Stew-000-1-0-011/mini-shirasu2/minishirasu-firm/spec.md

# minishirasu-firm
モタドラmini-shirasuのファームウェア。

board/下に基板の回路図等(sch, brd)がある。マイコンはSTM32F103C8T6。

設計の詳細は `docs/superpowers/specs/2026-10-03-minishirasu-firm-design.md` にある。

## 制御

CANで目標値を読み、モーターを動かす。

制御モードは電流、速度、位置の3つ。
カスケードしており、速度制御モードでは加速度FFを、位置制御モードでは速度FFと加速度FFを一緒に渡す。
加速度FFは外乱を含まない慣性分で、`accel_to_current`(= J/Kt)を掛けて電流に直し、速度PIの出力に足す。

電流制御は20kHz(PWMの毎周期)、速度・位置制御は1kHz。

## PWMとADC

TIM1のセンターアラインPWM。片側だけをPWMし、反対側はLow固定にする。

シャントはローサイド共通の1本なので、電流を測れるのは片側のハイサイドがONの間だけ。
ADCはONパルスの中央(カウンタの谷)で発火するようにする。
これはstm32f1xx-halのADCではできないので、レジスタ直打ちする。

- コンペア値の反映(更新イベント)はカウンタの山。`RCR = 1`をカウンタの起動前に書く。
- ADCのトリガはTIM1のチャネル4。`OC4REF`をTRGOに出し、谷の直前で立ち上げる。
- モーター電流の符号は、その周期に出していたデューティの向きから復元する。
- デューティが小さいとONパルスがサンプル時間より短くなり、電流を実際より小さく読む。

## 向き

正方向は、正のデューティ(PWMA側を駆動)で回る向き。逆回りを正にしたい場合は上位側で符号を反転する。

モーターとエンコーダの向きが食い違っていると、速度・位置ループが正帰還になって暴走する。
食い違いは設定`encoder_reversed`で吸収する。

## 通信

区切りのないバイトストリームを4本使う。CANではストリームごとにIDを1つ割り当て、
フレームのデータをストリームのバイト列としてそのまま連結する。IDは`src/config.rs`の定数。

| ストリーム | 向き | 既定のID | メッセージ |
|---|---|---|---|
| 目標値 | 受信 | 0x100 | TargetCurrent, TargetVelocity, TargetPosition |
| 状態 | 送信 | 0x101 | Status |
| コマンド | 受信 | 0x200 | SetMode, SetParam, ResetFault, SetOrigin |
| 応答 | 送信 | 0x201 | Ack, Nack, FaultNotice |

メッセージは `COBS( 種別 | ペイロード | CRC-8/SMBUS )` のあとに区切りの0x00。数値はリトルエンディアン。
種別、ペイロード、設定ID、Nackの理由は設計文書の「プロトコル」を見ること。

## 使い方

設定値に既定値はない。起動したら、まず`SetParam`で全項目(0x00〜0x23)を設定する。
全項目が揃って検証に通るまで、有効化(`SetMode`)は受け付けず、`Status`も送られない。
`Status`を受け取るには`status_period_ms`(0x24)も設定する。

1. `SetParam`で全項目を設定する。
2. `SetMode`で制御モードに入る。入った直後の目標値は、電流0 / 速度0 / 現在位置。
3. 目標値を送る。現在のモードと合わない目標値は捨てられる。
4. `SetMode`(0)で出力を止める。出力を止めるとモーターはフリーになる(ブレーキは掛からない)。

ドライバIC(MPQ6528)が異常を検出すると、出力を止めて`FaultNotice`を送り、`ResetFault`が来るまで復帰しない。
通信が途絶えても出力は止めない。ソフト側の過電流・電圧・温度の保護もない。

## 実機での確認手順

モーターを回す前に、上から順に確かめる。

1. 書き込んで起動ログを見る。`isense offset=...`が出て、エラーが出ないこと。
   - `update event is not at the peak`が出たら、`src/board.rs`の`RCR_BEFORE_START`を反対にして書き込み直す。
   - `ADC trigger or update event timing is wrong`が出たら、ADCが谷でトリガされていない。
2. オシロでISENSEのテストパッドとPWMAを見て、ADCのサンプル時刻が電流波形の平らな部分に入っていることを確かめる。
3. `SetParam`で全項目を設定する。電流上限`imax`とゲインは小さい値から始める。
4. `Status`が届くこと。母線電圧が実測と合うこと。
5. 手でモーターを回し、位置と速度の大きさが合うことを見る(`encoder_cpr`の確認)。
6. 電流モードで小さい正の電流を流し、`Status`の速度が正になることを見る。負なら`encoder_reversed`を切り替える。
7. 速度モード、位置モードを順に試す。
8. ログに`current loop missed the peak`が出ないことを見る。出る場合は電流ループの計算が25µsの半周期に間に合っていない。

### CANなしで試す

`cargo run --release --features bench`で書き込むと、CANからの指示なしで動く。
試験の内容は`src/bench.rs`の`PLAN`を書き換えて決める。

- `settings`を`SetParam`として順に設定し、`mode`に入り、`target`を与え、`run_ms`後に出力を止める。
  CANで受けたときと同じ入口に流し込むので、設定の検証と状態機械は同じコードを通る。
- `mode`が0なら設定だけして、出力は無効のままにする。
- 100msごとに`bench: mode=... i=... w=... th=... vdc=... temp=... flags=... late=...`をログに出す。
- コマンドが拒否されると`nack: command=... reason=... param=...`がログに出る。
- 目標値を与えた直後の400周期(20ms)ぶん、電流と出力を毎周期記録し、出力を止めたあとで
  `cap <位置>: i=[...] c=[...]`として書き出す。`i`は電流のADC値(1あたり約0.0201A)、
  `c`はコンペア値(1800でデューティ100%、PWMA側が正)。

CANの初期化は走るので、トランシーバがつながっていない基板では起動時に止まる。
