Stew-000-1-0-011/mini-shirasu2/docs/数値表現.md

# 数値表現

md-core の制御計算は、既定では固定小数点で行う。対象の STM32F103（Cortex-M3）には FPU がなく、f32 がソフトウェア演算になるため。
feature `f32` を有効にすると、同じ API のまま中身が浮動小数点になる（PC でのシミュレーションや FPU 付きマイコン用）。

## per-unit

信号とゲインは基準値で割って無次元化（per-unit 化）してから計算する。

| 量 | 基準値 | Config のフィールド |
|---|---|---|
| 電圧 | V_b | `vdcmax` |
| 電流 | I_b | `ibase` |
| 速度 | ω_b | `wbase` |
| トルク | Kt·I_b | （電流の per-unit 値と同じになるので持たない） |
| 位置 | 1 回転 = 1.0 | （基準値なし） |

`Config` は物理単位（V、A、rad/s、秒、回転）の f32 で持つ。per-unit への変換、周期 T の掛け込みは各 `Param::new` が行い、値が型に収まらなければ `ConfigError` を返す。
上限値（`imax`、`vmax`、`wmax`、`pmax`、`duty_max`、`dead_duty`）とゲイン（`cki`、`wkp`、`wki`、`pkp`）が負の場合や、`duty_max` が 1 を超える場合もエラーにする。`ke` と `wb` の符号は制限しない。

`NotPositive` になるのは次の場合。
- 基準値（`vdcmax`、`ibase`、`wbase`）、周期（`cperiod`、`wperiod`）、`ckp`、`i_threshold` が、正の有限値でない。
- `i_threshold` を `ibase` で割った値が Q3.28 の分解能より小さく、0 になる。0 だと電流 0 でもデッドタイム補償が掛かってしまうため。

変換後のゲインが 8 以上になる場合は `OutOfRange` になる（例: `ckp·ibase/vdcmax`、`wkp·wbase/ibase`）。基準値を選び直してゲインを収める。
- 電流の `ckp` は、`ibase` を小さくするか `vdcmax` を大きくすると per-unit 値が下がる。
- 速度の `wkp` は、`wbase` を小さくするか `ibase` を大きくすると per-unit 値が下がる。
- `ibase` と `wbase` は他の値の変換にも使われるので、変えたら他の値も範囲に収まるか確認する。

アンチワインドアップのゲイン `kb`（`cki·cperiod/ckp`）は 1 で頭打ちにする。飽和中の積分は kb が 2 を超えると発散するため。kb = 1 なら、飽和した周期のうちに積分値を戻せる。

`Measurement` と各制御器の目標値は per-unit で渡す。ADC の生値や CAN の物理値からの変換はファーム側の仕事。

## 型の使い分け

| 型 | 中身（既定 / feature `f32`） | 範囲 | 用途 |
|---|---|---|---|
| `Q3_28` | i32 / f32 | [-8, 8) | per-unit の信号とゲイン |
| `Q3_60` | i64 / f64 | [-8, 8) | 積分器 |
| `Q16_16` | i32 / f64 | [-32768, 32768) | 位置（回転） |

- 信号は ±1 前後になるが、誤差（最大 ±2）や和、1 を超えるゲインのために整数部を 3bit 持たせている。
- 積分器は、1 周期ぶんの増分（ゲイン × 誤差）が Q3.28 の分解能より小さくなりうる。積を丸めずに Q3.60 で積算することで、小さな偏差でも積分が進む。
- 位置は多回転を扱うので整数部を広く取る。位置誤差にゲインを掛けるときは、掛けてから Q3.28 にする（先に変換すると 8 回転で飽和する）。
- `Q16_16` はラップせず ±32768 回転で飽和する。速度制御で回り続けるなど、位置が増え続ける使い方では上限に張り付く。ファーム側で扱いを決めること。

## 演算の約束

- 加減乗算と符号反転、`abs` はあふれたら型の上限・下限に飽和する。ラップして符号が反転することはない。これは安全策であり、通常動作で飽和に達しないよう基準値とゲインを選ぶ。
- 除算は `checked_div`（範囲外・0 除算で `None`）と `unchecked_div`（範囲内であることを呼び出し側が保証。debug ビルドでは違反を検出）だけ。逆数や除算は割る数が小さいだけで範囲を外れるので、値の範囲を知っている側が使い分ける。
  - 母線電圧の逆数：測定値は範囲を保証できないので `checked_div` を使う。逆数が収まらない（母線電圧が `vdcmax/8` 以下の）ときは測定値を更新せず、前回の値を使い続ける。
  - デッドタイム補償：|i| がしきい値未満のときだけ `i / しきい値` を計算するので、結果は (-1, 1) に収まる。
- 型をまたぐ変換は明示的な関数（`to_q3_28` など）だけで、暗黙の変換はない。
- 整数との境界は次の4つだけ。ADC の生値やエンコーダのカウント、タイマのコンペア値とのやり取りに使う。制御周期の中で浮動小数点を使わずに済ませるためのもの。
  - `Q3_28::scale_int(n)`：per-unit 値 × 整数を、最も近い整数に丸める（デューティ × タイマ周期 → コンペア値）。
  - `Q3_28::mul_int(n)`：ゲイン × 整数（ADC 生値 × 換算係数 → 電流・電圧）。
  - `Q16_16::scale_int(n)`：位置 × 整数を、最も近い整数に丸める（`n = 65536` で Q16.16 の生の値になる）。
  - `Q16_16::from_ratio(num, den)`：整数の比（累積カウント ÷ 1 回転あたりのカウント → 位置）。
