Stew-000-1-0-011/mini-shirasu2/docs/制御.md

## 制御器全体
TODO: 図、graphviz
```
            トルク外乱FF┐
位置P -> + -> 速度PI -> + -> ノッチ -> + -> /Kt -> 電流PI -> 
 |         |                          |
 位置目標値  速度目標値                トルク目標値
```
トルク外乱FFは測定値由来のθやωを使うため、共振が乗りうる。よってノッチの前で加算している。

### 制限とアンチワインドアップ
TODO: 現状コードの振る舞いの理解

### 負荷モデルによるトルクFF:
T_ff(θ, ω) ~ T_const + T_c * sgn(ω) + Tm(θm) + To(θo) + B * ω + C * ω * |ω|
TODO: 物理的意味

Tm, Toはテーブルで保持

### 電流制御器: 電流 -> デューティ比
入力電流 |> 電流制限 |> アンチワインドアップ付きPI制御 |> +逆起電力補償 |> +デッドタイム補償 |> 電圧制限 |> デューティ比化 |> デューティ制限
TODO: 足すとか×とかがいい感じになったブロック図もどき

電圧制限は`duty_max * vdc`。vdcは測定値なので上限も毎サイクル引き直す。固定値にすると、負荷で母線が下がったときにデューティが1を超えてPWM側で黙って切られ、制御器が飽和に気づけない。

TODO: デッドタイム補償もまとめて説明したい
v = Ri + Ldi/dt + Ke*ω
I(s) = 1/(Ls + R) * (V(s) - Ke*Ω(s))

よってP(s) = 1/(Ls + R), D(s) = -Ke*Ω(s)。

I制御はほしい(Tips参照)。で、このとき極零相殺によりPの極を打ち消すことができる。打ち消せばCPは1次遅れになり、オーバーシュートが生じなくできるし、考えやすくなる。この条件がKi/Kp = R/L。
`Ki = w_c*R, Kp = w_c*L`とすると、
伝達関数はτ = 1/w_cとして1/(τs + 1)。
あとはw_cをいじりつつ安定性と即応性のバランスをユーザーが調整する。

デッドタイム補償は符号が揺れる0付近で暴れないよう、`sgn(i) = i == 0 ? 0 : i < 0 ? -1 : 1`の代わりに`sat(i) = clamp(i / i_threshold, -1, 1)`を用いている。

### トルク制御器はありません
トルクセンサのフィードバックを使う制御器は、必要に応じpmd-coreの電流制御器使いつつ自作してくれ～

### ノッチフィルタ
機械の共振を消すために入れる。
TODO: 良いパラメータの推定方法、理論の深堀り

### 速度制御器: 速度 -> トルク
Jdω/dt = T - T_L
Ω(s) = (1/Js)(T(s) - T_L(s))
P(s) = 1/Js, D(s) = -T_L(s)

例によってI制御は欲しい。しかし、今回はPIで極零相殺はできない。Ki = 0となってしまう。
```
C(s) = (Kp*s + Ki)/s
P(s)C(s) = 1/Js * (Kp*s + Ki)/s
Y(s)/R(s) = PC / (1 + PC) = (Kp*s + Ki) / (Js^2 + Kp*s + Ki)
Y(s)/D(s) = P / (1 + PC) = s / (Js^2 + Kp*s + Ki)
```
オーバーシュートするし、その激しさと外乱の定常偏差の減り具合はトレードオフになる(らしい、追ってない)。

そこで、**2自由度PID**というのを使う。目標値をr, 出力をyとして
`PID-2(r, y) = Kp(br - y) + Ki(r - y) + Kd(cr - y)`
パラメータはKp, Ki, Kdに加えb, cだ。
積分項だけ新たなパラメータがないのは、入れてしまうと定常偏差が出てしまうからだ。

これを使うと、
```
Y/R = (bKp*s + Ki) / (Js^2 + Kp*s + Ki)
Y/D = s / (Js^2 + Kp*s + Ki)
```
となる。
Y/Dを決めた後、Y/Rを調節することができるわけだ。
これにより、外乱応答を調節した後、目標値応答の零点をいじれる(目標値応答の極は通常と変わらない)。
これにより目標値のオーバーシュートや立ち上がりの調節を、外乱と別に行えるわけだ。

実装はD項なしの`Kp(bu - ω) + Ki∫(u - ω)`。目標速度uは`±wmax`に制限し、制限後の値を積分にも使う。

標準的なパラメータ決定方法はTODO。

### 位置制御器: 位置 -> 速度
θ = ∫ωdt
Θ = Ω/s

ろくに対処できる外乱がないので、P制御でいい

## 速度オブザーバ
おそらくCRSのモタドラの低速でのカクツキはインクリメンタルエンコーダ直入れのせい。
なめらかにする方法にはいくつかあるが、今回は汎用性の高い速度オブザーバによる方法を採用
TODO: オブザーバって何？

なんか更新式があるらしいんで、それをもとに速度を出すコードを用意。

## 軌道生成
位置をステップ状に渡されてもなんとかなるように。
台形とかS字とかあるらしい。TODO。

## 加振生成
同定時に使う。上位との通信を高頻度にやるのは大変なので、マイコン側に用意。

## その他TODO
- 離散化や計算による遅れの未考慮
- 飽和の理論的扱い

### 制御理論赤点勢のためのTips
- モデル化は現実とのズレがつきものだよ！
- 極は、多項式/多項式型の伝達関数の分母 = 0の解。極を用いると伝達関数はΣ定数/(s - 極_i)^nの形で書ける。
- とりわけ多い外乱として定数的なものがある(トルク制御における重力等)。定数的な外乱をFFで消そうとしたとき、打ち消しきれないFFとの差も定数になる。また入力がステップ的であることも多い。
  ステップ入力やステップ外乱を入れるとすると、最終値の定理からCPが原点で極を持たないとき定常誤差が残る。これへの対処としてI制御を使う
- 逆に偏心やコギング等、周期的な誤差が支配的になることもある。この場合はFFで極力落としたり、「繰り返し制御」なるものを使うらしい。I制御で却って定常誤差がひどくなったりすることもあるよ！
- FFは極を変えないし、現実と少しのズレでもあればそのまま定常誤差になるが、オーバーシュート低減等に役立つ
- 極零相殺を不安定な極に対し試みないこと！ちょっとのズレがあるので結局発散するし、ぴったりだとしても理論的に不安定になるって言えるらしい。知らんけど。
- PIDの微分項など、`a[t] - a[t-1]`をやるものはローパスを入れるのが鉄則らしい。だからPIDの伝達関数のD項には普通ローパスぶんの一次遅れが入るらしい。ローパス付きの微分を近似微分とかいうらしい
