Stew-000-1-0-011/mini-shirasu2/minishirasu-firm/board/mini_shirasu.brd

## EAGLE design minishirasu-firm/board/mini_shirasu.brd (2026-10-03)

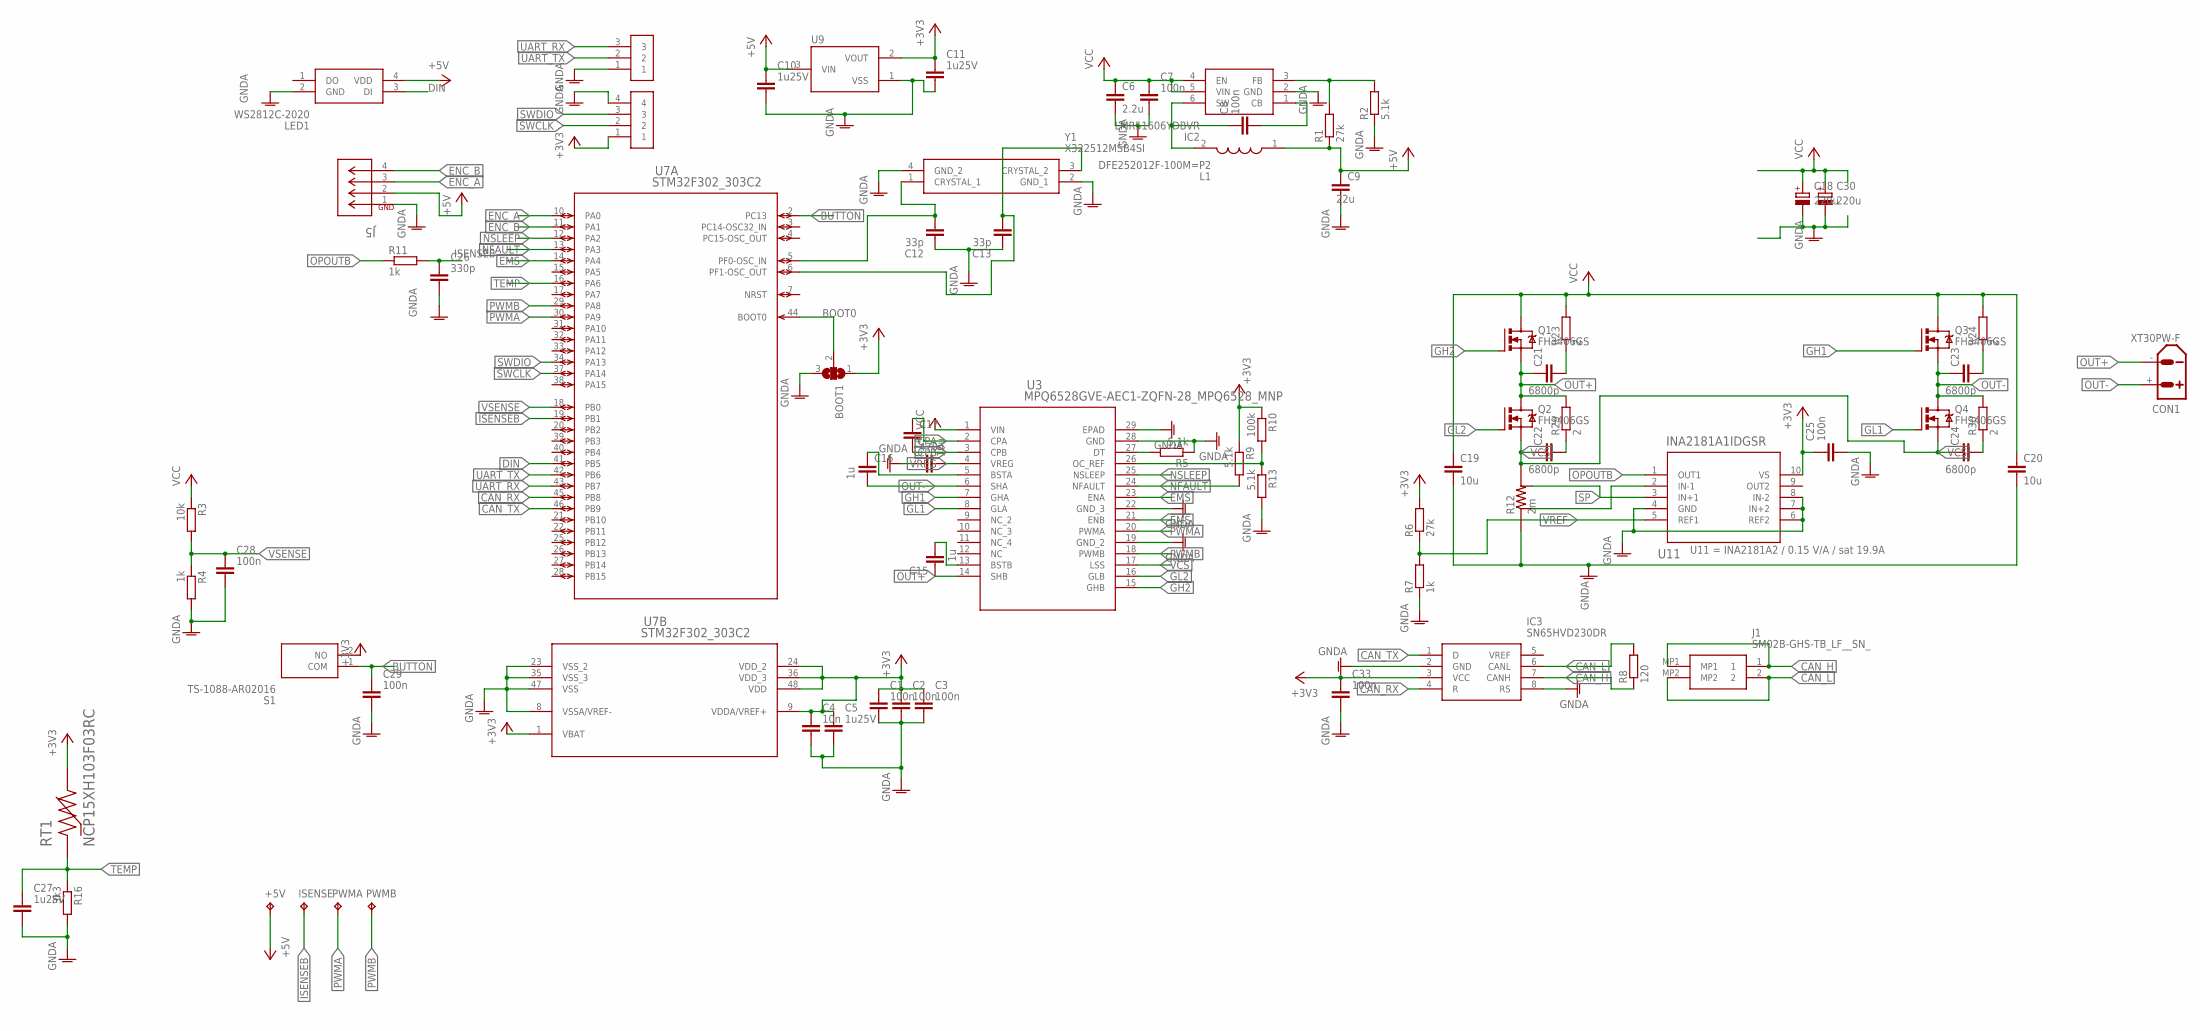
[picture p1: schematic mini_shirasu.sch]

Parts:
+5V: TPB1,27; B1,27
BOOT1: SJ2W; SJ_2
C1, C2, C3, C7, C8, C25, C28, C29, C33: 100n; CAPC1005X60
C4: 10n; CAPC1005X60
C5, C10, C11, C27: 1u25V; CAPC1005X60
C6: 2.2u; C0805
C9: 22u; C0805
C12, C13: 33p; CAPC1005X60
C14, C19, C20: 10u; C0805
C15, C16: 1u; C0603
C17: 470n; C0805
C18, C30: 220u; CAPAE1030X1050N
C21, C22, C23, C24: 6800p; C0603
C26: 330p; CAPC1005X60
CON1: XT30PW-F
IC2: LMR51606YDBVR; SOT95P280X145-6N
IC3: SN65HVD230DR; SOT127P600X175-8N
ISENSE: TPB1,27; B1,27
J1: SM02B-GHS-TB_LF__SN_; SM02BGHSTBLFSN
J5: EP2.5-4-SIDE; CONN4_1744426-4
L1: DFE252012F-100M=P2; DFE2HCAH1R0MJ0L
LED1: WS2812C-2020; WS2812C2020
PWMA: TPB1,27; B1,27
PWMB: TPB1,27; B1,27
Q1, Q2, Q3, Q4: FH3406GS; DFN-8-5X6-FH3406GS
R1, R6: 27k; R0402
R2, R5, R9, R13: 5.1k; R0402
R3: 10k; R0402
R4, R7, R11: 1k; R0402
R8: 120; R0603
R10: 100k; R0402
R12: 2m; 2512-4PAD
R16: 3k3; R0402
R23, R24, R29, R30: 2; R0603
RT1: NCP15XH103F03RC; THRMC1005X55N
S1: TS-1088-AR02016; TS1088AR02016
U3: MPQ6528GVE-AEC1-ZQFN-28_MPQ6528_MNP; QFN-28_MPQ6528_MNP
U7: STM32F302_303C2; LQFP48-7X7MM
U9: XC6206; SOT95P240X110-3
U11: INA2181A1IDGSR; DGS10; MANUFACTURER_PART_NUMBER INA2181A2IDGSR
U$1: PIN_HEADERPIN_HEADER; PIN_HEADER
U$2: 3PIN_HEADER
Y1: X322512MSB4SI

Connections:
!EMS: U3.21 (ENB), U3.23 (ENA), U7.14 (PA4)
+3V3: BOOT1.1, C1.1, C2.1, C3.1, C4.1, C5.1, C11.1, C25.1, C33.1, IC3.3 (VCC), R6.2, R9.1, R10.1, RT1.2, S1.2 (NO), U7.1 (VBAT), U7.9 (VDDA/VREF+), U7.24 (VDD_2), U7.36 (VDD_3), U7.48 (VDD), U9.2 (VOUT), U11.10 (VS), U$1.1
+5V: +5V.TP, C9.1, C10.1, J5.2, L1.1, LED1.4 (VDD), R1.1, U9.3 (VIN)
BOOT0: BOOT1.2, U7.44 (BOOT0)
BST1: C16.1, U3.5 (BSTA)
BST2: C15.2, U3.13 (BSTB)
BUTTON: C29.1, S1.1 (COM), U7.2 (PC13)
CAN_H: IC3.7 (CANH), J1.1, J1.MP1, R8.1
CAN_L: IC3.6 (CANL), J1.2, J1.MP2, R8.2
CAN_RX: IC3.4 (R), U7.45 (PB8)
CAN_TX: IC3.1 (D), U7.46 (PB9)
CB: C8.2, IC2.1 (CB)
CPA: C17.1, U3.2 (CPA)
CPB: C17.2, U3.3 (CPB)
DIN: LED1.3 (DI), U7.41 (PB5)
DT: R5.2, U3.27 (DT)
ENC_A: J5.3, U7.10 (PA0)
ENC_B: J5.4, U7.11 (PA1)
FB: IC2.3 (FB), R1.2, R2.2
GH1: Q3.4 (G), U3.7 (GHA)
GH2: Q1.4 (G), U3.15 (GHB)
GL1: Q4.4 (G), U3.8 (GLA)
GL2: Q2.4 (G), U3.16 (GLB)
GNDA: BOOT1.3, C1.2, C2.2, C3.2, C4.2, C5.2, C6.2, C7.2, C9.2, C10.2, C11.2, C12.1, C13.1, C14.1, C18.2 (-), C19.2, C20.2, C25.2, C26.2, C27.2, C28.2, C29.2, C30.2 (-), C33.2, IC2.2 (GND), IC3.2 (GND), IC3.8 (RS), J5.1, LED1.2 (GND), R2.1, R4.2, R5.1, R7.1, R12.1, R12.2 (1), R13.2, R16.2, U3.19 (GND_2), U3.22 (GND_3), U3.28 (GND), U3.29 (EPAD), U7.8 (VSSA/VREF-), U7.23 (VSS_2), U7.35 (VSS_3), U7.47 (VSS), U9.1 (VSS), U11.4 (GND), U11.6 (REF2), U11.7 (IN+2), U11.8 (IN-2), U$1.4, U$2.1, Y1.2 (GND_1), Y1.4 (GND_2)
ISENSEB: C26.1, ISENSE.TP, R11.2, U7.19 (PB1)
unnamed: C12.2, U7.5 (PF0-OSC_IN), Y1.1 (CRYSTAL_1)
unnamed: C13.2, U7.6 (PF1-OSC_OUT), Y1.3 (CRYSTAL_2)
unnamed: C22.2, R29.1
unnamed: C24.2, R30.1
unnamed: R12.5 (3), U11.2 (IN-1)
unnamed: C23.2, R24.1
unnamed: C21.2, R23.1
NFAULT: R9.2, U3.24 (NFAULT), U7.13 (PA3)
NSLEEP: U3.25 (NSLEEP), U7.12 (PA2)
OC_REF: R10.2, R13.1, U3.26 (OC_REF)
OPOUTB: R11.1, U11.1 (OUT1)
OUT+: C15.1, C21.1, CON1.-, Q1.1 (S), Q1.2 (S), Q1.3 (S), Q2.5 (D), Q2.6 (D), Q2.7 (D), Q2.8 (D), Q2.9 (D), R29.2, U3.14 (SHB)
OUT-: C16.2, C23.1, CON1.+, Q3.1 (S), Q3.2 (S), Q3.3 (S), Q4.5 (D), Q4.6 (D), Q4.7 (D), Q4.8 (D), Q4.9 (D), R30.2, U3.6 (SHA)
PWMA: PWMA.TP, U3.20 (PWMA), U7.30 (PA9)
PWMB: PWMB.TP, U3.18 (PWMB), U7.29 (PA8)
SP: R12.6 (4), U11.3 (IN+1)
SW: C8.1, IC2.6 (SW), L1.2
SWCLK: U7.37 (PA14), U$1.2
SWDIO: U7.34 (PA13), U$1.3
TEMP: C27.1, R16.1, RT1.1, U7.16 (PA6)
UART_RX: U7.43 (PB7), U$2.3
UART_TX: U7.42 (PB6), U$2.2
VCC: C6.1, C7.1, C18.1 (+), C19.1, C20.1, C30.1 (+), IC2.4 (EN), IC2.5 (VIN), Q1.5 (D), Q1.6 (D), Q1.7 (D), Q1.8 (D), Q1.9 (D), Q3.5 (D), Q3.6 (D), Q3.7 (D), Q3.8 (D), Q3.9 (D), R3.1, R23.2, R24.2, U3.1 (VIN)
VCS: C22.1, C24.1, Q2.1 (S), Q2.2 (S), Q2.3 (S), Q4.1 (S), Q4.2 (S), Q4.3 (S), R12.3 (2), R12.4 (2), U3.17 (LSS)
VREF: R6.1, R7.2, U11.5 (REF1)
VREG: C14.2, U3.4 (VREG)
VSENSE: C28.1, R3.2, R4.1, U7.18 (PB0)

Notes on the sheet:
U11 = INA2181A2 / 0.15 V/A / sat 19.9A

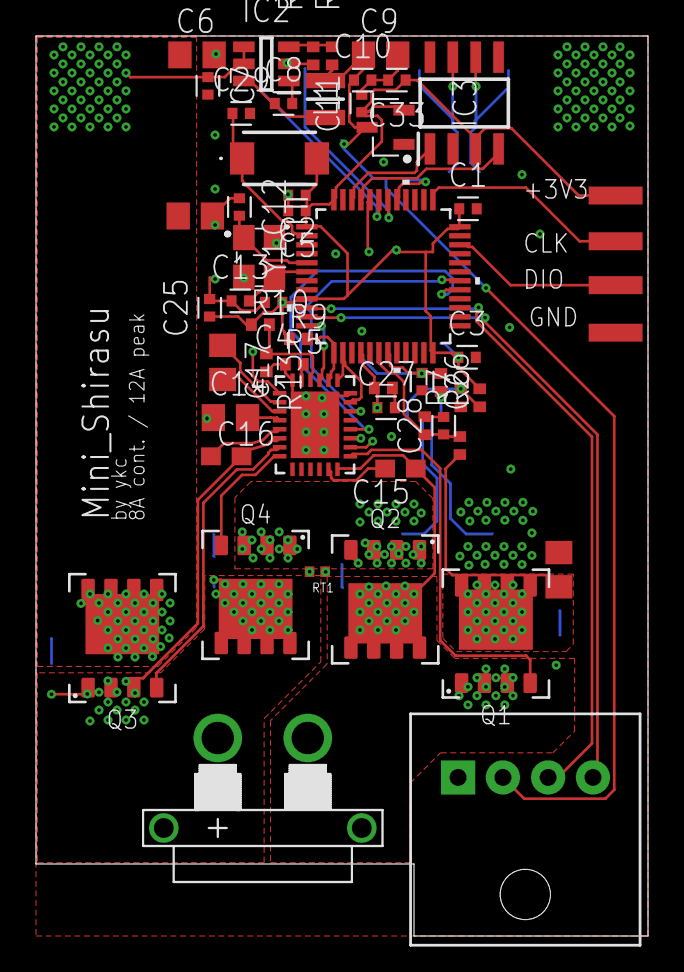
[picture p2: board mini_shirasu.brd from above]

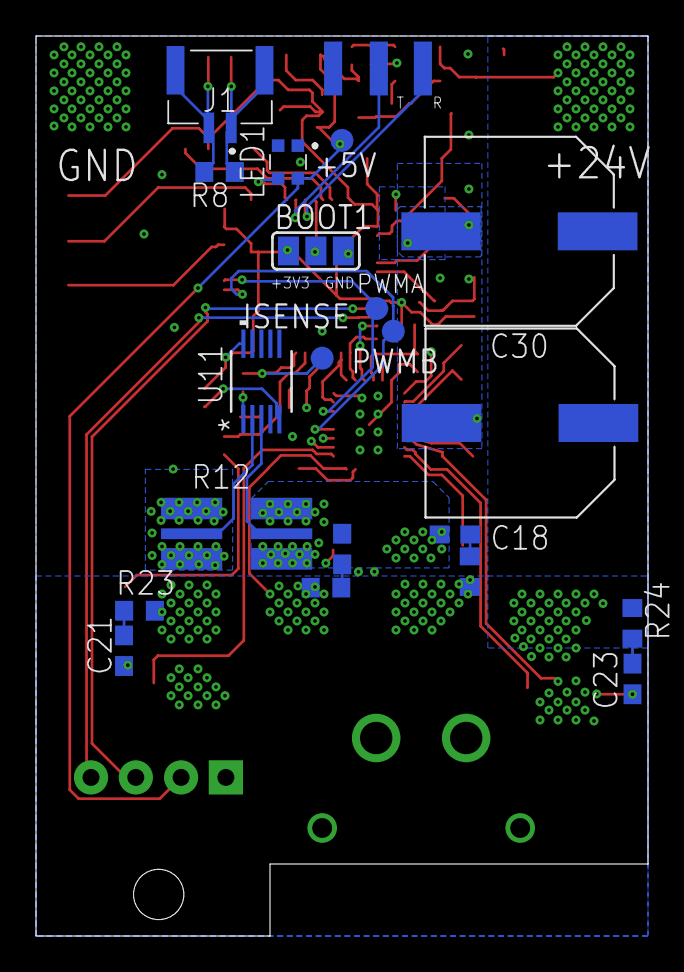
[picture p3: board mini_shirasu.brd from below]

Board: 4 copper layers, 34.0 x 50.0 mm, 74 parts (21 on the bottom side), 52 nets.
