Stew-000-1-0-011/mini-shirasu2/(commit log)

2026-10-03 Plan: hold vdc_min in CurrentParam instead of BusParam
2026-10-03 Plan: use vdcmax/8 as the bus voltage floor, drop vdcmin
2026-10-03 Add fixed-point number types Q3_28, Q3_60, Q16_16
    [fixed.rs, lib.rs]
2026-10-03 Port controllers to fixed-point per-unit types
    [controller.rs]
2026-10-03 Clamp anti-windup gain and reject zero dead-time threshold
2026-10-03 Apply dead-time compensation as voltage before the limit
2026-10-03 デッドタイム補償をdutyクランプ前に入れ込んだ
2026-10-03 Spec: update CCR at the peak, trigger ADC from OC4REF
2026-10-03 Rename minisirasu-firm to minishirasu-firm and remove old sources
    [mini_shirasu.brd, mini_shirasu.sch]
2026-10-03 Add integer boundary operations to fixed-point types
    Claude-Session: https://claude.ai/code/session_01XNr5i9z8ibucq78UtzMFbR
    [fixed.rs]
2026-10-03 Add encoder position and velocity estimation
    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
2026-10-03 Add PWM compare and ADC scaling
    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
2026-10-03 Add board register access and CAN transport
    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
2026-10-03 Wire control loops and communication with RTICX
    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
2026-10-03 Fix update event phase and RTT logging found on the board
    - Write RCR after starting TIM1 so the update event lands on the peak.
    UG loads the repetition counter, which moved it to the valley.
    - Enable the DMA1 clock so the debugger can read memory during wfi.
    Without it RTT logs were lost once the idle task started sleeping.
    - Log before waiting for the CAN bus, since can::init blocks.
    [board.rs, main.rs]
2026-10-03 Add bench feature to run without CAN, and stop latching late interrupts
    - feature "bench": feed settings, mode and target from src/bench.rs
    into the same entry points CAN uses, and log the state every 100ms.
    - A late ADC interrupt after start-up now counts as a missed peak
    instead of latching a fault. A long defmt log masks interrupts for
    more than the 14us margin, which tripped the fault on the board.
    - Log the cause of a fault and every Nack.
    [bench.rs, lib.rs, main.rs]
2026-10-03 Shorten ADC conversion so the current loop meets the peak
    The current loop takes about 14us, but with VSENSE at 28.5 and TEMP
    at 55.5 cycles the interrupt started 11.6us after the valley, leaving
    13.4us. Most cycles missed the peak on the board.
    - Sample all three channels for 7.5 cycles (5us in total).
    - Measure where in the PWM period the loop starts and writes the
    compare values, and print the maximum in the bench log.
    - bench: current mode without a motor, encoder counts per rev of the
    drive shaft.
    [bench.rs, board.rs, main.rs, shared.rs]
2026-10-03 bench: capture the current waveform, and skip the first ADC interrupts
    - Record the current reading and the compare value for 400 cycles
    after the target is set, and dump them after the output stops.
    - The first ADC interrupt after init is a stale pending one whose
    phase is unrelated to the trigger. It tripped the timing check once
    init got slower, so discard the first 8 interrupts.
    - bench settings for the RZ-735VA-8519: encoder direction, counts per
    rev from the gear ratio, and current gains that fit its short
    electrical time constant.
    [bench.rs, main.rs]
2026-10-03 bench: settings that ran current, velocity and position mode
    Gains found on the board with the RZ-735VA-8519 through the 11.86:1
    gearbox. The plan is left at mode 0 so flashing it does not move the
    motor.
2026-10-03 bench: time the current loop calculations on the target
    Run the current controller, the ADC scaling and the compare
    conversion with the cycle counter before interrupts start, and log
    the cycles per call. Conversions from f32 are kept out of the timed
    region because soft float dominated the first measurement.
2026-10-03 Replace the division in soft_sign with a reciprocal multiply
    The 64-bit software division took about 485 cycles on the Cortex-M3,
    almost half of the current loop. Divisor keeps the reciprocal, scaled
    by 2^60 because it can exceed the Q3.28 range, and Q3_28::div_by
    multiplies by it. The result is truncated toward zero and stays within
    one LSB of the exact quotient.
    Measured on the board: update with a small current went from 867 to
    392 cycles.
    [controller.rs, fixed.rs]
2026-10-03 bench: leave the plan at current mode, output disabled
2026-10-27 Add duty mode that drives PWM without the current loop
    SetMode(5) enters duty mode. TargetDuty (0x04) carries a duty in
    -1..=1 that the current loop clamps to duty_max and writes to the
    compare registers as is, so the motor and driver can be checked
    without relying on the current sense or gains. Fault keeps code 4.
    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
