Stew-000-1-0-011/mini-shirasu2/(notices)

Notices in the files:
parts and their libraries:
stm32_mcu: COPYRIGHT: Copyright (C) 2016 Accelerated Designs. All rights reserved
texas-instruments: COPYRIGHT: Copyright (C) 2018 Accelerated Designs. All rights reserved
MPQ6528GVE-AEC1-Z: COPYRIGHT: Copyright (C) 2026 Ultra Librarian. All rights reserved.
